phatvu1294/du-an-module-thi-nghiem-cam-bien/documents/Tai_Lieu_Ky_Thuat.pdf

TÀI LIỆU KỸ THUẬT

### 1.1. MODULE ĐẦU RA KẾT HỢP LOA ĐÈN

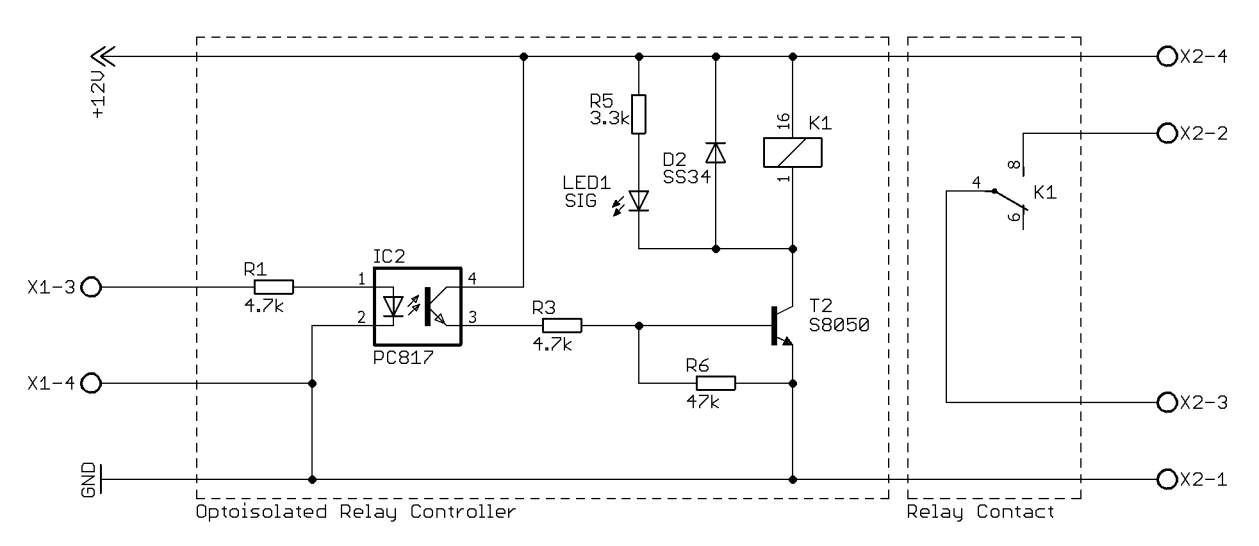
[picture p1: figure]

Hình 1. Nguyên lý module đầu ra

Khối điều khiển cuộn hút:

Để bình thường, không có dòng vào cực B của T2, T2 khoá, cuộn hút của relay K1 không có điện, tiếp điểm của relay không đổi trạng thái.

Khi X1-3 có đủ điện vào (chân 1 và 2) của opto, led phát quang hoạt động, opto dẫn, dòng điện sẽ đi từ +12V qua (chân 4 và 3) PC817, qua R3, đi vào cực B của T2, làm T2 dẫn. K1 lúc này có điện (chiều từ +12V qua K1, qua T2, về GND). K1 hoạt động, tiếp điểm của relay thay đổi trạng thái.

R1 có nhiệm vụ hạn dòng cho led phát quang opto, D2 có nhiệm vụ ngắn mạch dòng ngược sinh ra từ K1, khi K1 ngắt đột ngột (hiện tượng tự cảm trên

cuộn dây K1).

Khối tiếp điểm đầu ra:

Khối tiếp điểm đầu ra được kết nối với tải đầu ra (chẳng hạn: loa đèn).

### 1.2. MODULE CẢM BIẾN NHIỆT RTD

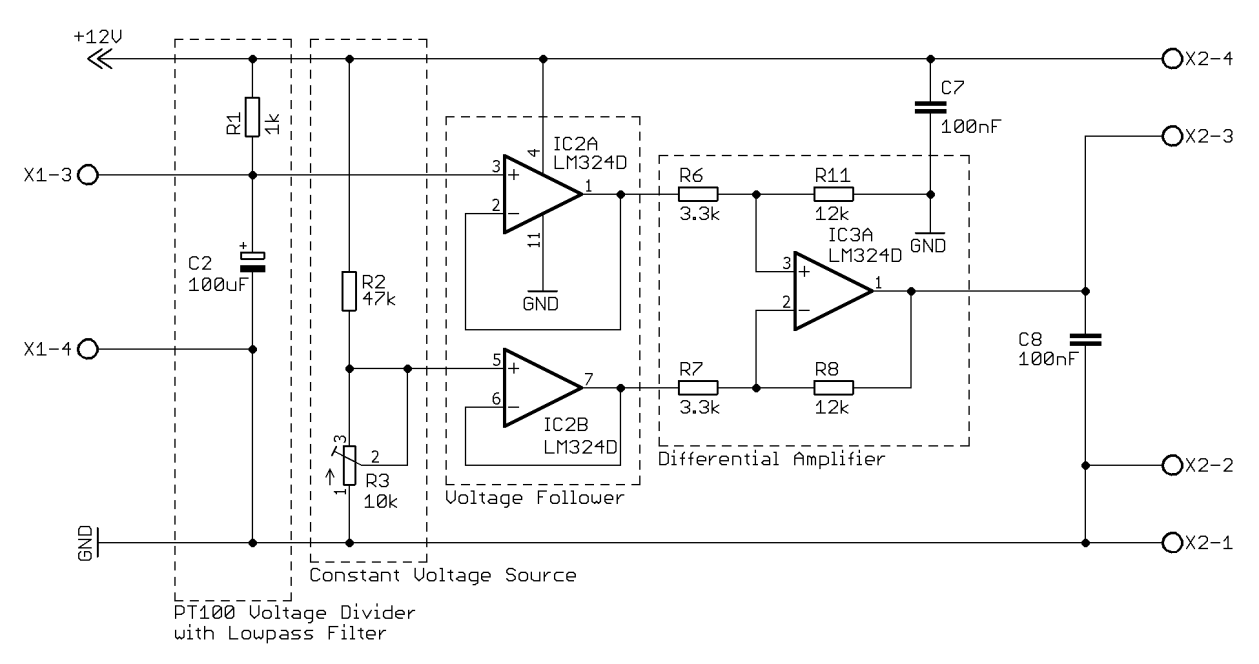
[picture p2: figure]

Hình 2. Nguyên lý module cảm biến nhiệt RTD (PT100)

Khối chia áp và lọc tần thấp RTD:

Với RTD, chúng ta sẽ chuyển tín hiệu nhiệt độ về tín hiệu điện áp, 0 đến 800°C về 0 đến 8V, như vậy 10mV sẽ ứng với 1°C.

Gắn PT100 vào X1-3 và X1-4. Lúc này RTD và R1 sẽ hình thành mạch chia áp, R1 và C2 có nhiệm vụ lọc tần thấp, đảm bảo tín hiệu ra tại điểm giữa ổn

định.

Tại nhiệt độ 0°C, tra bảng ta có giá trị điện trở là 100Ω. Điện áp tại điểm

giữa:
1.091(V)
100 1000

12 100
R | R
V | R
V
RTD0 | 1
PWR | RTD0
0 | =
+

×
=
+

×
=

Tại nhiệt độ 800°C, tra bảng ta có giá trị điện trở là là 375,7Ω. Điện áp tại

điểm giữa:
3.277(V)
375,7 1000

12 375,7
R | R
V | R
V
RTD800 | 1
PWR | RTD800
800 | =
+

×
=
+

×
=

Khối nguồn hằng số:

Khối cũng sử dụng mạch chia áp, giá trị điện áp tại điểm giữa được điều chỉnh thông qua biến trở tinh chỉnh, khối có nhiệm vụ tạo điện áp sai lệch tại điểm ban đầu trước khi đưa vào khối khuếch đại vi sai.

Khối mang áp:

Khối có nhiệm vụ chính là đệm điện áp, bảo vệ tín hiệu đầu ra, và điện áp đầu ra bằng điện áp đầu vào.

Khối khuếch đại vi sai:

Ta có điện áp tại đầu ra:

( | )
( | )

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
CONST
11 | 6 | 7
8 | 7 | 11
OUT | RTD | R

R
V | .
R | R .R
R | R .R
V | V | .

Nếu
R6 = R7

, R8 = R11

thì
( | )
( | )
( | )
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
= - ÷

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
RTD CONST
7

8
CONST
11 | 6 | 7
8 | 7 | 11
OUT | RTD | R

R
V | V | .
R

R
V | .
R | R .R
R | R .R
V | V | . | (1)
- Tại nhiệt độ 0°C ta muốn điện áp ra là 0V, thay vào (1) ta có:
( | )
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
CONST R

R
0 | 1.091 V | . | , ta có
R | 0 7 ≠ , R | 0 8 ≠ | V | 1.091(V) Þ CONST =
- Tại nhiệt đô 800°C ta muốn điện áp ra là 8V, thay vào (1) ta có:
( | ) | 3,660
2.186

8
R

R
R

R
8 3.277 1.091.

7

8

7

8 | Þ | = | = ÷

÷
ø

ö
ç

ç
è

æ
= | -
| • Chọn
R7 = 3.3k Þ R8 = 3.3k ×3,660 =12.078k ≈12k

Như vậy ta sẽ đặt giá trị nguồn hằng về 1.091(V),
R6 = R7 = 3.3k ,
R8 = R11 =12k | để chuyển đổi nhiệt độ 0 đến 800°C về 0 đến 8V (10mV/1°C).

### 1.3. MODULE CẢM BIẾN NHIỆT TCK

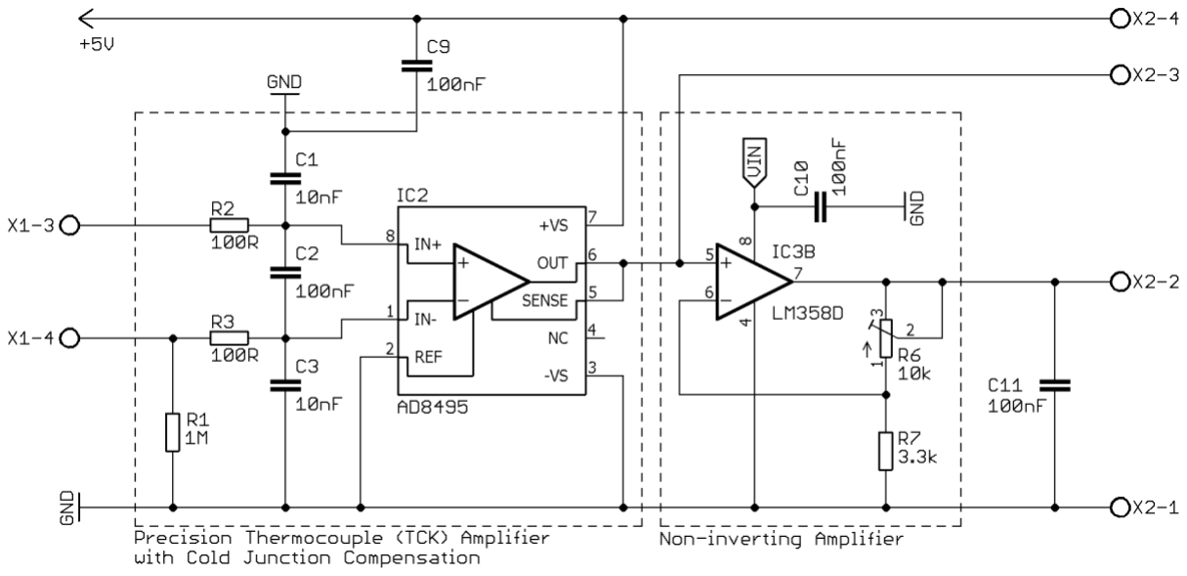
[picture p3: figure]

Hình 3. Nguyên lý module cảm biến Thermo-Couple K (TCK)

Khối chuyển đổi nhiệt TCK sang Analog AD8495:

AD8495 là IC chuyển tổi tín hiệu nhiệt độ từ cặp nhiệt can K sang điện áp, với độ phân giải 5mV/1°C. Với giải đầu vào cặp nhiệt can K từ 0 đến 1000°C sẽ cho ra điện áp 0 đến 5V.

R2, R3, C1, C2, C3 là bộ lọc tần thấp trước khi tín hiệu điện áp từ cảm biến TCK được đưa vào bộ khuếch đại.

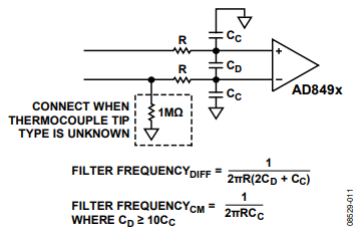
[picture p4: figure]

Điện trở kéo R1 nối đất đảm bảo đầu vào IN- của cảm biến mức 0V. Tránh gây ra thêm sai số đầu ra khi không có tín hiệu từ cảm biến.

Bộ khuếch đại tín hiệu không đảo:

Tín hiệu ra từ bộ chuyển đổi sẽ được đưa vào bộ khuếch đại không đảo, bộ này sẽ khuếch đại tín hiệu điện áp lên 2 lần để điện áp đầu ra đạt được từ 0 đến

10V (10mV/1°C).

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
= | +

7

6

OUT | OUT _ AD8495 | R R
V | V | . 1

Để tín hiệu được khuếch đại lên 2 lần ta có: 2
R

R
1

7

6 + =
, chọn

R7 = 3.3k Þ R6 = 3.3k

, như vậy ta sẽ điều chỉnh biến trở R6

về 3.3k.

### 1.4. MODULE CẢM BIẾN NHIỆT BÁN DẪN

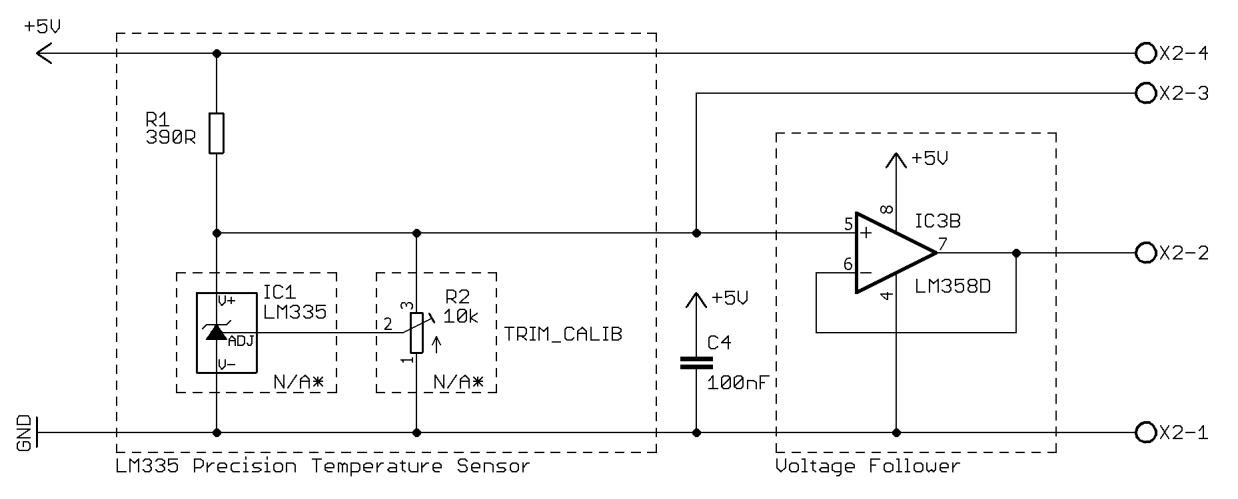
[picture p5: figure]

Hình 4. Nguyên lý module cảm biến nhiệt bán dẫn LM335

Khối cảm biến nhiệt LM335:

LM335 là cảm biến nhiệt độ với đầu ra tỉ lệ với điện áp 10mV/1°K. Giải nhiệt độ đo được từ -55°C đến 150°C.

R1 được chọn để đảm bảo tín hiệu dòng điện cung cấp vào LM335 nằm trong dải từ 400µA đến 5mA.

Hiệu chỉnh nhiệt độ sử dụng chân ADJ:

Một biến trở R2 được kết nối với LM335 được kết nối với LM335 cho phép hiệu chỉnh đầu ra khi biết chính xác một giá trị nhiệt độ cho trước.

0

OUT _ T | OUT _ T
T

T
V | V
| 0
= | ×

Với T là nhiệt độ sau khi hiệu chỉnh (°K), T0

là nhiệt độ hiệu chỉnh (°K).

Khối mang áp:

Khối có nhiệm vụ chính là đệm điện áp, bảo vệ tín hiệu đầu ra, và điện áp đầu ra bằng điện áp đầu vào. Tín hiệu điện áp Analog được đo tại đầu ra khối LM335 (X2-3) hoặc đầu ra của đầu ra của khối mang áp (X2-2).

### 1.5. MODULE CẢM BIẾN ÁNH SÁNG LDR

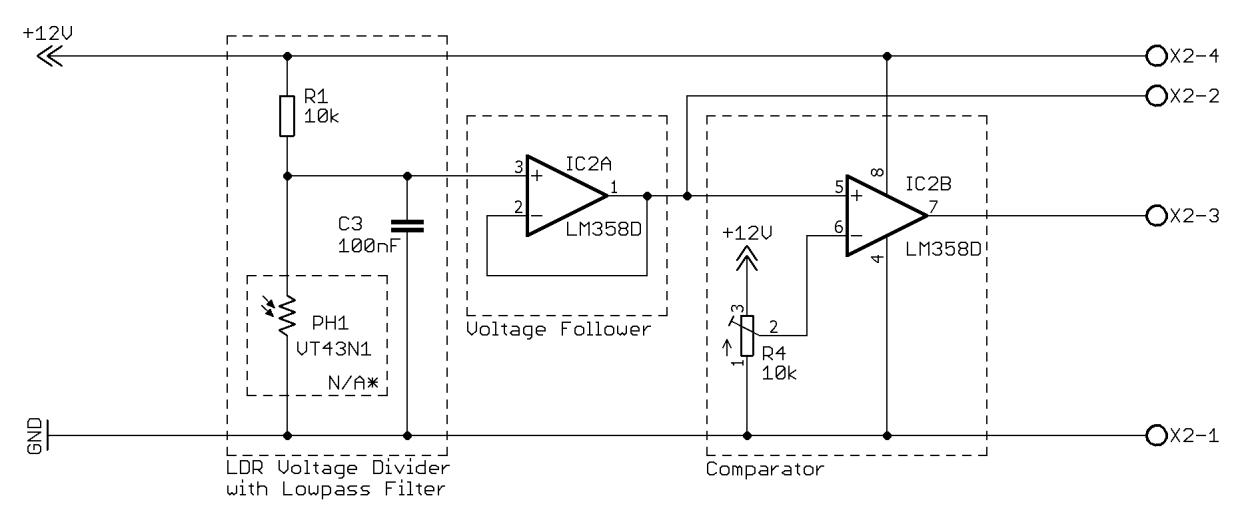
[picture p6: figure]

Hình 5. Nguyên lý module cảm biến ánh sáng LDR

Khối chia áp và lọc LDR:

R1 và PH1 hình thành mạch chia áp, ta có điện áp ra tại điểm giữa:

R | ?
R | R

R1
V | 12 V | 12 12 | PH1
1 | PH1
PH1 | R1 | Þ | =
+
= | - | = | - | ×

Lưu ý: 12V là nguồn lý tưởng, cần đo lại điện áp nguồn cung cấp để tính

chính xác hơn.

Khối mang áp:

Khối có nhiệm vụ chính là đệm điện áp, bảo vệ tín hiệu đầu ra, và điện áp đầu ra bằng điện áp đầu vào. Tín hiệu điện áp Analog được đo tại điểm giữa hoặc đầu ra của đầu ra của khối mang áp.

Khối so sánh:

Với khối so sánh ta có:

î

í

ì
=

+

S

S
OUT V

V
V
+ | -
+ | -
<

>

IN | IN
IN | IN
V | V
V | V
với
VS

là nguồn cấp cho OPAM.

Trong mạch
VS+ | =12V

(nối với nguồn cung cấp) và VS- = 0V

(nối với

GND).

Một biến trở
R4 | có nhiệm vụ đặt điện áp tại
VIN-

(điện áp so sánh). Và
trong mạch được điều chỉnh cứng bằng nửa điện áp nguồn cung cấp (khoảng

6V).

Như vậy khi được chiếu sáng, điện trở PH1 rất thấp, tín hiệu điện áp
VPH1

giảm mạnh, khi đó
VPH1 < VIN-

, lúc này điện áp ra
VOUT = 0V . Ngược lại, khi trong bóng tối, điện trở trên tăng mạnh cỡ MΩ, điện áp
VPH1

tăng mạnh, khi đó

VPH1 > VIN- và điện áp ra
VOUT =12V

(lý thuyết, thực tế khoảng 10.3V với

OPAM LM358).

### 1.6. MODULE ĐO TỐC ĐỘ ĐỘNG CƠ ENCODER

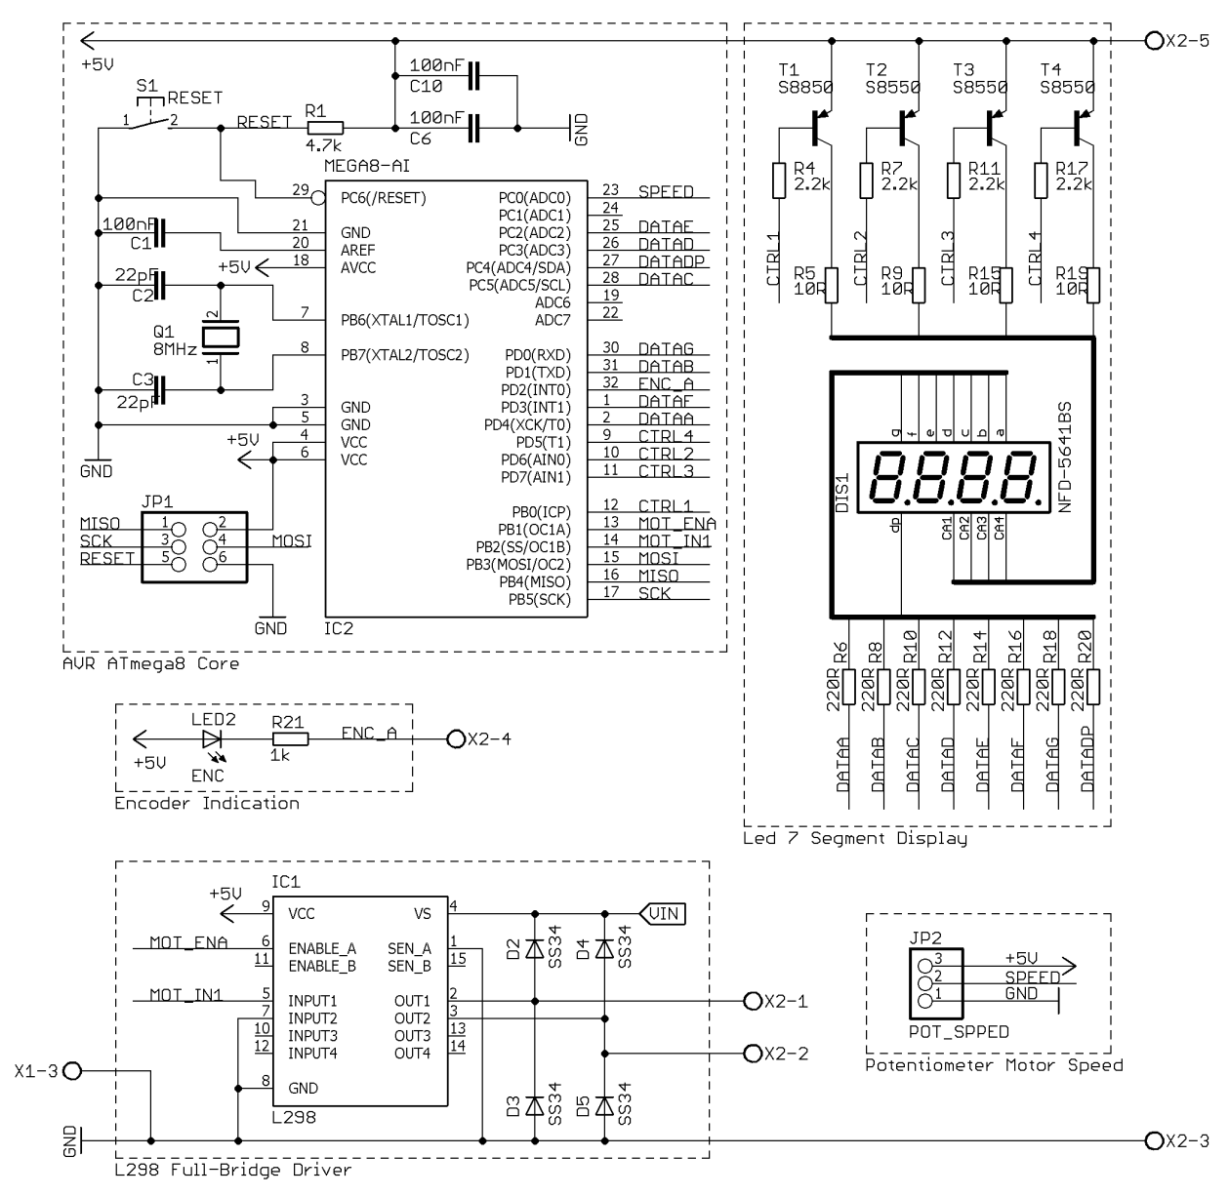
[picture p7: figure]

Hình 6. Nguyên lý bộ điều khiển module đo tốc độ encoder

Bộ điều khiển tốc độ và đo tốc sử dụng vi điều khiển ATMega8 làm bộ điều khiển chính, khối hiển thị số xung trên giây sử dụng LED7 thanh 4 số, driver điều khiển động cơ L298. Tốc độ động cơ sẽ được điều chỉnh bằng biến trở tích hợp trong bộ điều khiển.

Hướng dẫn tính toán tốc độ động cơ:

Với Động Cơ Encoder Giảm Tốc GM25-370 (50RPM) có các thông số

kỹ thuật như sau:

- Điện áp hoạt động: 12VDC
- Dòng không tải: 100mA
- Xung: 26 Xung/Vòng
- Tỉ số truyền: 1/78
- Công suất: 3W
- Kích thước: 50x24mm
- Đường kính trục: Φ4
- Chiều dài dây: 142mm
- Trọng lượng: 110g

Giả sử bộ điều khiển hiển thị 1608 xung/giây. Ta có tốc độ quay của động cơ khi chưa qua hộp giảm tốc là:

61,84(vòng / giây)
26

1608 N(rps) = =
hay:

N(rpm) = 61,84×60 = 3710,4(vòng / phút)

Tốc độ quay của động cơ khi qua hộp số là:

47,57(vòng / phút)
78

3710,4
NGEAR = | =

Lưu ý, với mỗi giá trị điện áp đặt vào 2 đầu động cơ, chúng ta sẽ có các tốc độ khác nhau ứng với mỗi mức điện áp đó.

### 1.7. MODULE CẢM BIẾN TỪ TRƯỜNG HALL

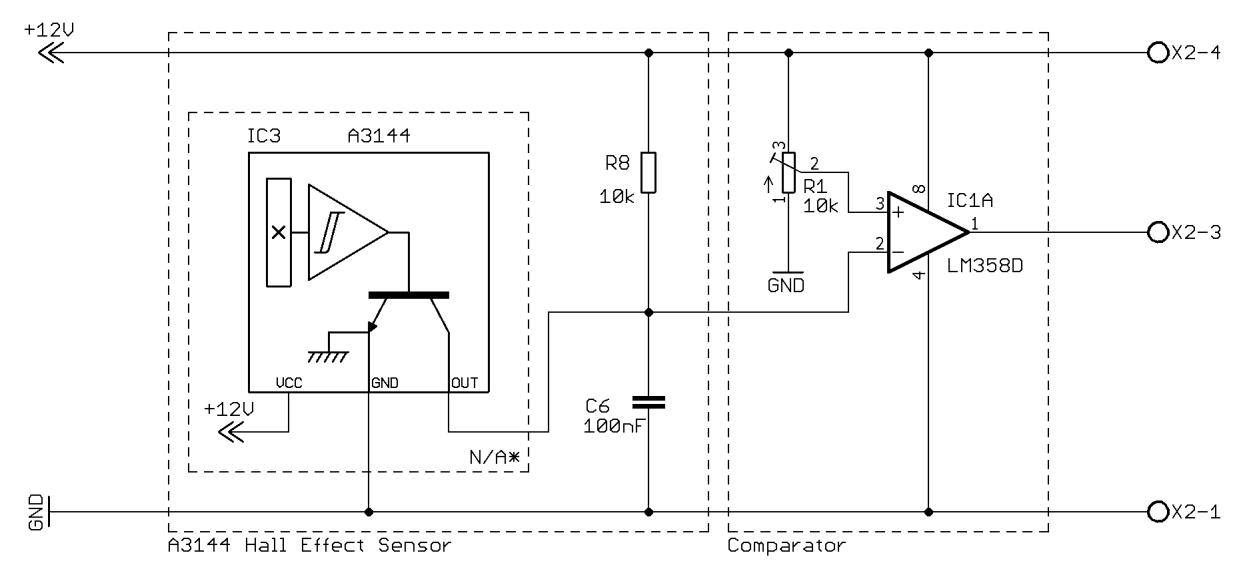
[picture p8: figure]

Hình 7. Nguyên lý module cảm biến từ trường Hall

Khối cảm biến từ trường A3144:

A3144 là một cảm biến từ khi có từ trường (nam châm) đặt vào đầu cảm biến thì sẽ có sự thay đổi trạng thái ở chân OUT.

Một điện trở
R8

được sử dụng để phân cực cho transistor được tích hợp

bên trong, đồng thời đặt mức điện áp ban đầu tại chân OUT mức cao. Khi có từ trường đặt vào đầu vào cảm biến, cực B transistor NPN tích hợp có tín hiệu, transitor lúc này khóa lại, làm cho chân OUT được chuyển xuống mức thấp.

Khối so sánh:

Một bộ so sánh đầu ra cho phép đảo mức tín hiệu logic tại đầu ra của khối.

### 1.8. MODULE CẢM BIẾN HỒNG NGOẠI

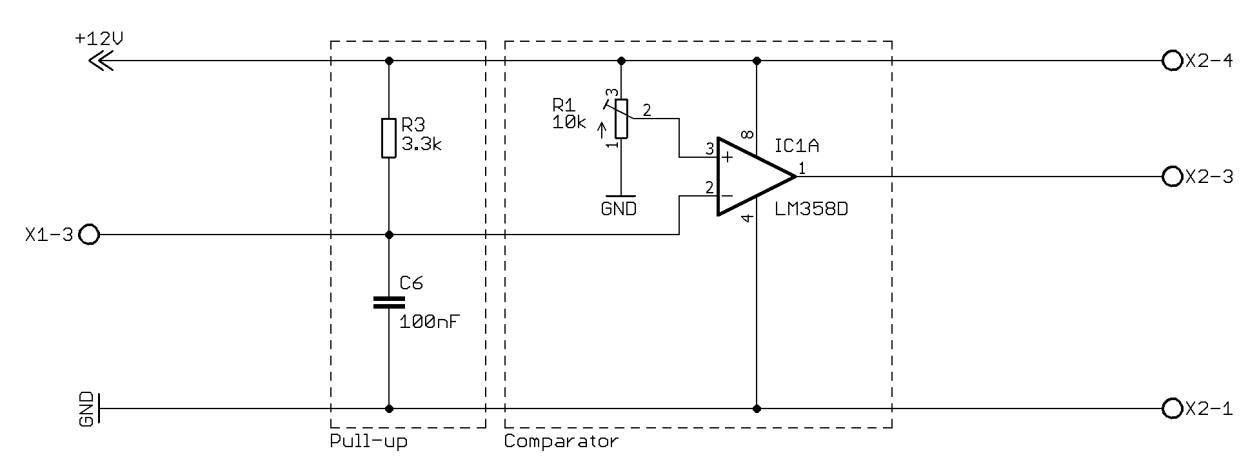
[picture p9: figure]

Hình 8. Nguyên lý module cảm biến hồng ngoại

phản xạ và thu phát độc lập

Khối trở kéo:

Cảm Biến Hồng Ngoại Phản Xạ E3F-DS30C4 là loại cảm biến NPN, bình thường khi chưa có vật cản, bộ thu RX không thể thu được tín hiệu phát ra từ TX, đầu ra tín hiệu đầu ra ở mức cao. Khi có vật cản, tia hồng ngoại phát ra từ TX sẽ được phản xạ lại bộ thu RX làm cho tín hiệu đầu ra đảo trạng thái xuống mức thấp.

Tương tự với Cảm Biến Hồng Ngoại Thu Phát Độc Lập E3Z-T61. Bộ phát và bộ thu sẽ được đặt đối mặt nhau, bình thường khi chưa có vật cản, bộ thu RX luôn nhận được tín hiệu từ TX, đầu ra tín hiệu đầu ra ở mức cao. Khi có vật cản, tia hồng ngoại bị cản lại và không thể đưa tới bộ thu làm cho tín hiệu đầu ra bị đảo trạng thái xuống mức thấp.

Khối so sánh:

Một bộ so sánh đầu ra cho phép đảo mức tín hiệu logic tại đầu ra của khối.

### 1.9. MODULE CẢM BIẾN TIỆM CẬN

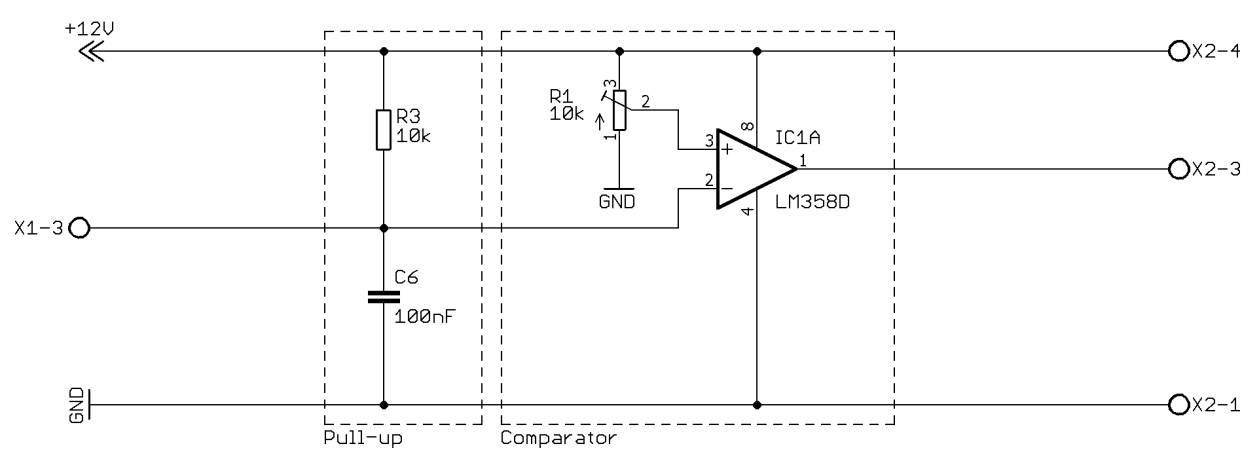
[picture p10: figure]

Hình 9.1. Nguyên lý module cảm biến tiệm cận kim loại

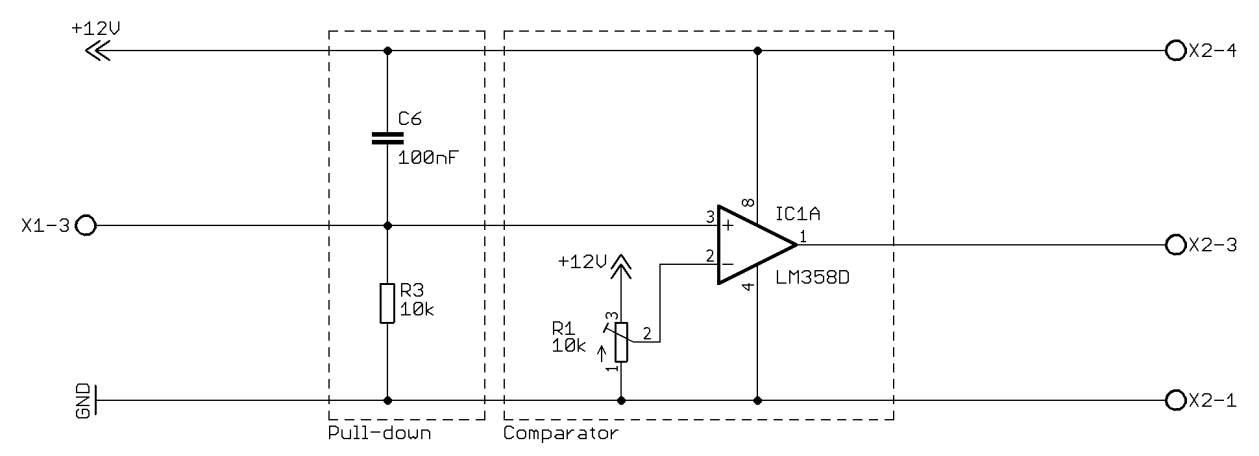
[picture p11: figure]

Hình 9.2. Nguyên lý module cảm biến tiệm cận kim loại và phi kim

Khối trở kéo:

Cảm Biến Tiệm Cận Omron E2E-X10ME1 là loại cảm biến NPN tiệm cận kim loại, bình thường khi chưa có vật cản kim loại, đầu ra tín hiệu đầu ra ở mức cao. Khi có vật cản kim loại, tín hiệu đầu ra đảo trạng thái xuống mức thấp.

Tương tự với Cảm Biến Tiệm Cận Omron E2K-X4MF1 là loại cảm biến

PNP tiệm cận kim loại và phi kim, bình thường khi chưa có vật cản kim loại hoặc phi kim, đầu ra tín hiệu đầu ra ở mức thấp. Khi có vật cản kim loại hoặc phi kim tín hiệu đầu ra bị đảo trạng thái lên mức cao.

Khối so sánh:

Một bộ so sánh đầu ra cho phép đảo mức tín hiệu logic tại đầu ra của khối

(kim loại) hoặc giữ nguyên trạng thái (kim loại và phi kim).

### 1.10. MODULE KHỐI NGUỒN

### 1.10.1. Module chuyển đổi điện áp trên các module

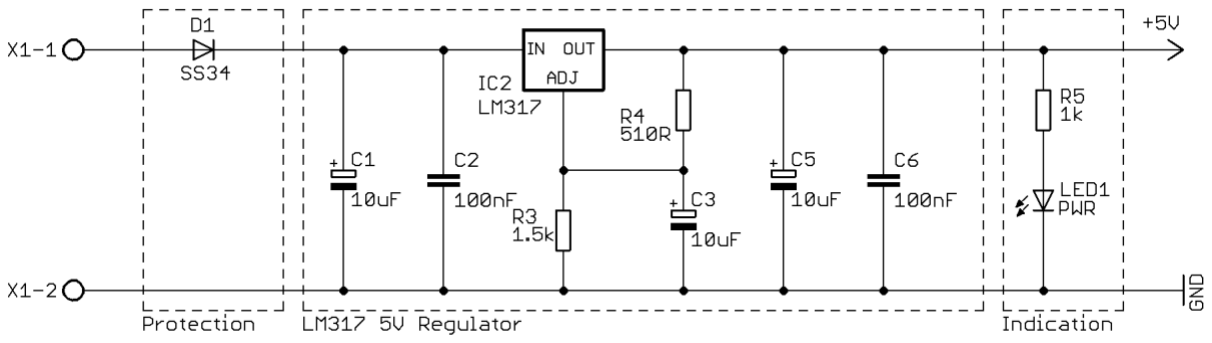
[picture p12: figure]

Hình 10.1. Nguyên lý bộ ổn áp +5V trên các module

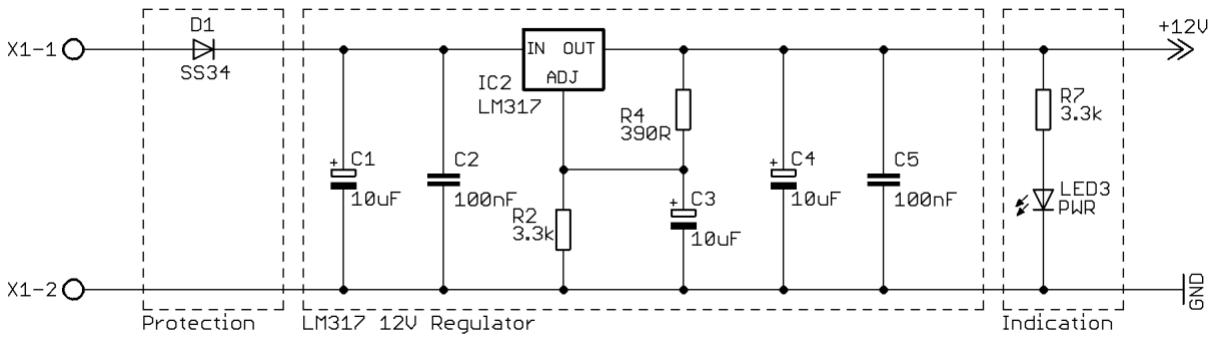
[picture p13: figure]

Hình 10.2. Nguyên lý bộ ổn áp +12V trên các module

Trên các bộ ổn áp của các module đều được tích hợp thêm diode bảo vệ, chống ngược khi cấp nhầm, khối ổn áp được thiết kế sử dụng dựa trên IC nguồn LM317 (LM337 ổn áp -), đây là dòng IC chuyển đổi hiệu suất cao thay thế cho dòng LM78XX. Tuy nhiên do sự sai số trên các trở chỉnh ADJ
R4

và
R2

dẫn

đến điện áp ra trên các module có sai số nhất định, do đó khi tính toán chúng ta cần đo lại điện áp nguồn cung cấp để hạn chế sai số.

### 1.10.2. Module nguồn

Đây là khối nguồn tạo các mức áp ra +15V, -15V, 5V để cung cấp cho các module hoạt động. Dòng cung cấp tối đa lên tới 5A.

GIAO DIỆN MODULE

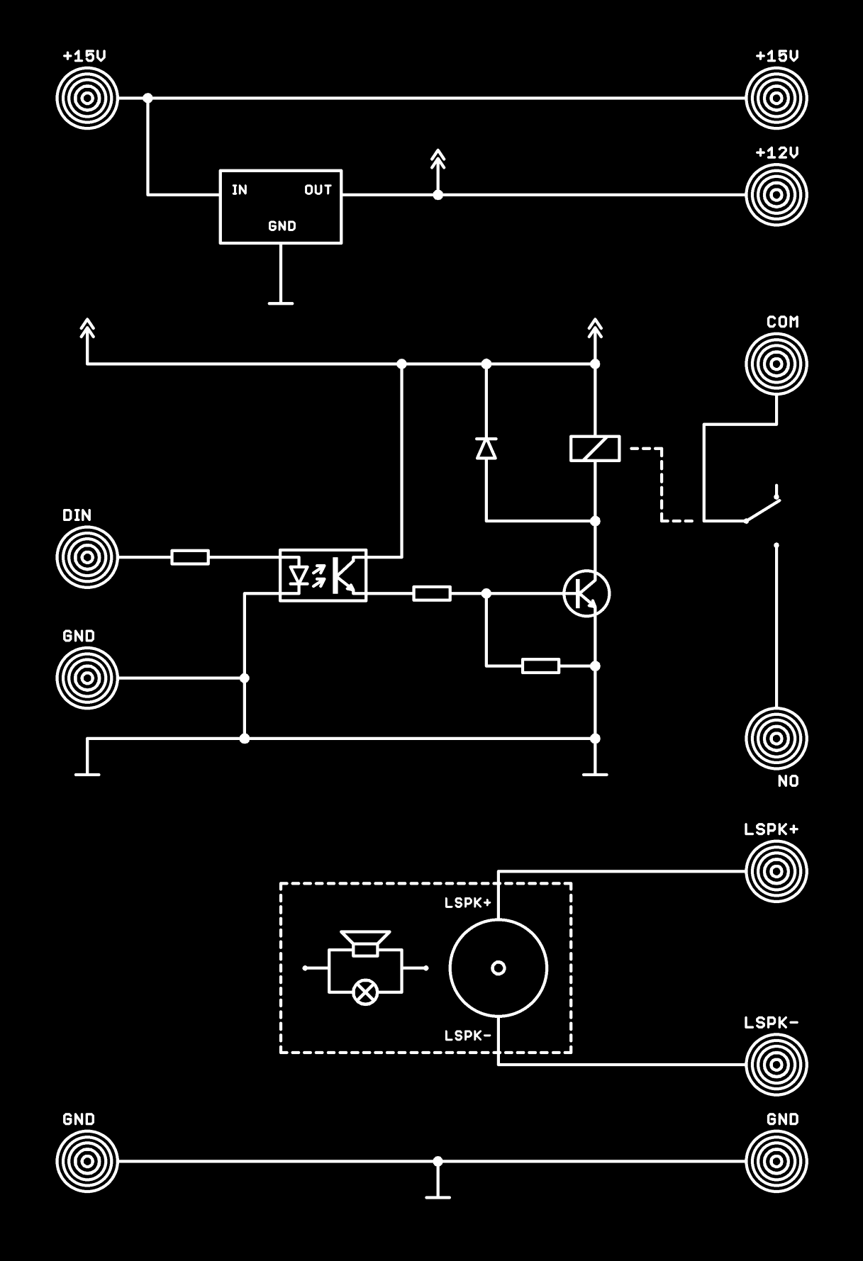
[picture p14: figure]

Hình 11. Giao diện module đầu ra

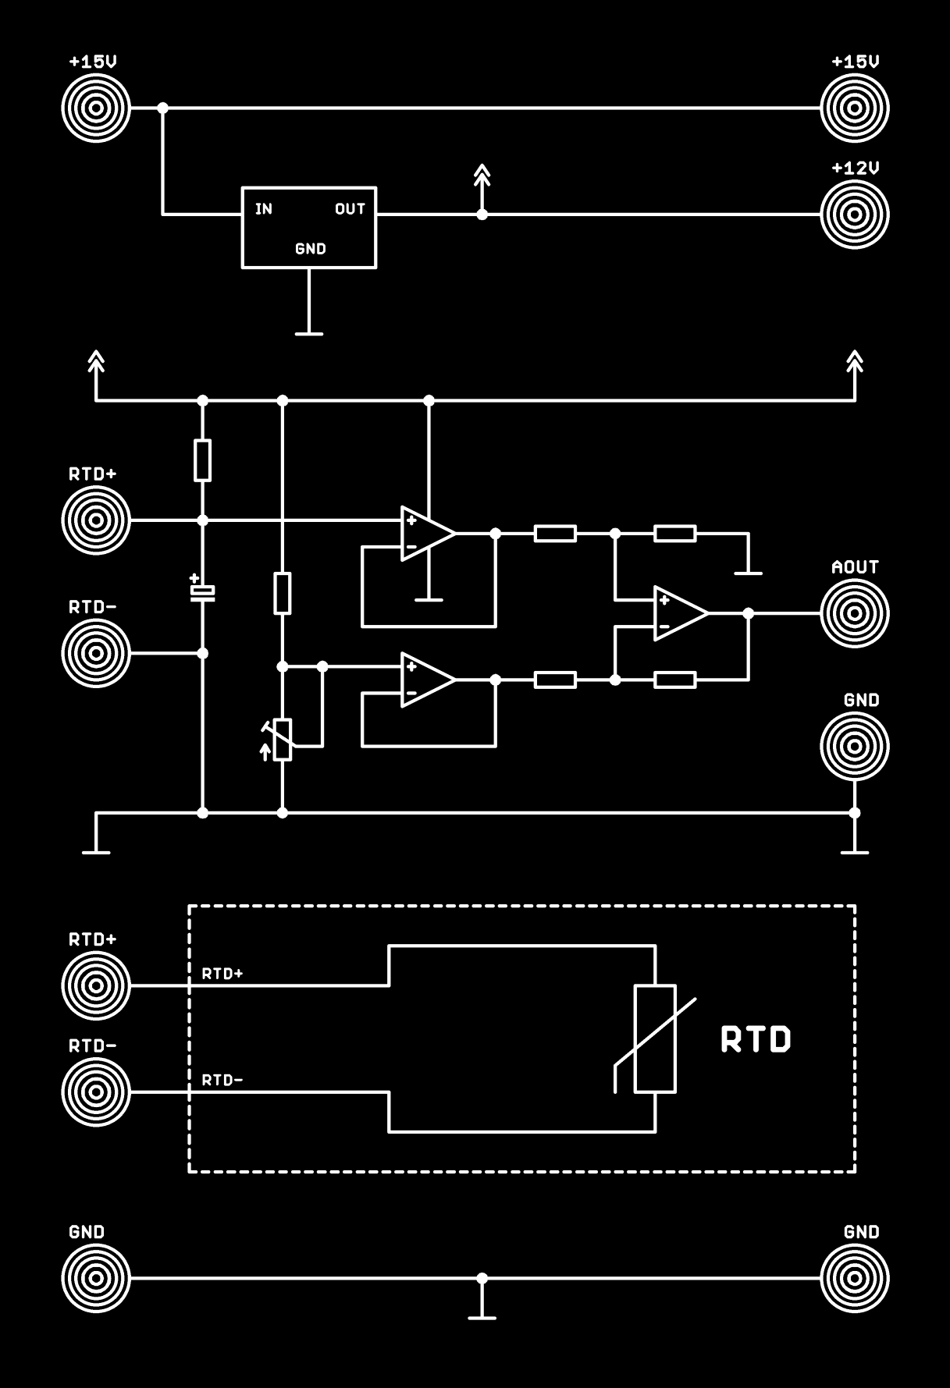
[picture p15: figure]

Hình 12. Giao diện module cảm biến nhiệt RTD (PT100)

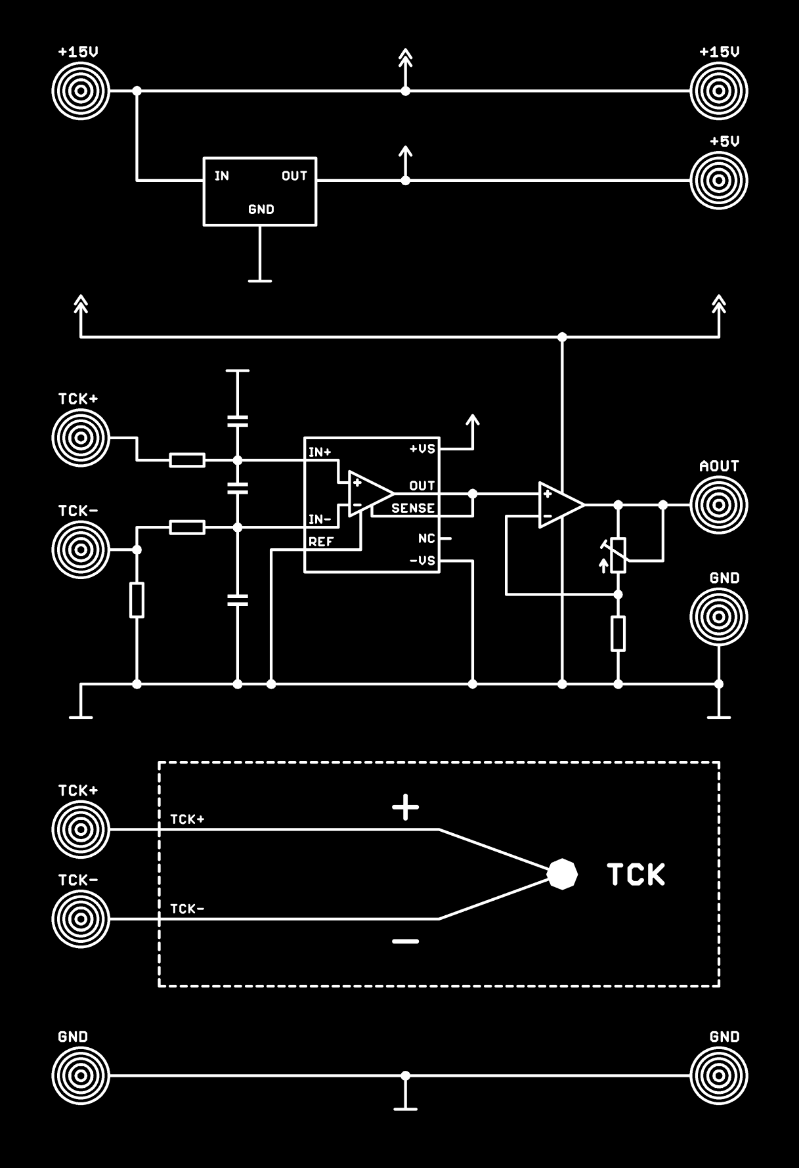
[picture p16: figure]

Hình 13. Giao diện module cảm biến nhiệt TCK

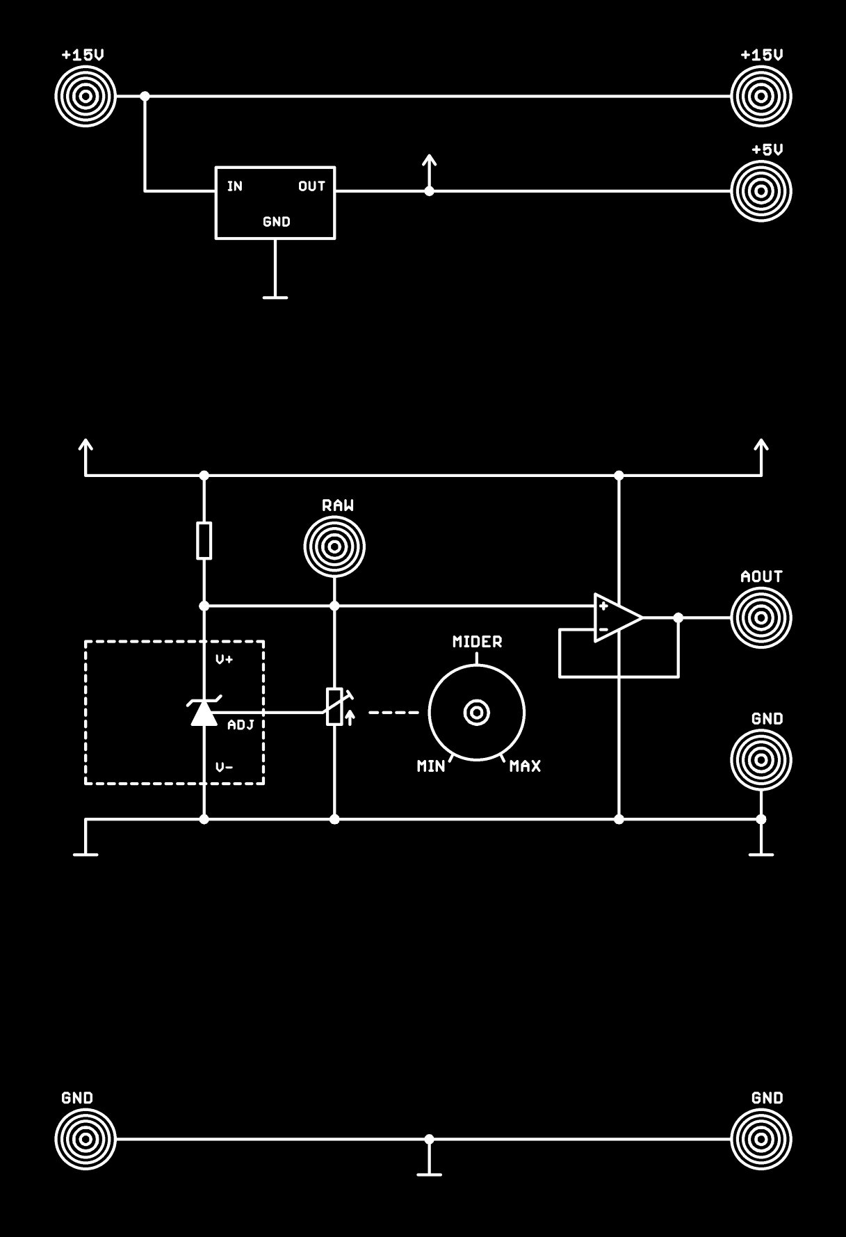
[picture p17: figure]

Hình 14. Giao diện module cảm biến nhiệt bán dẫn LM335

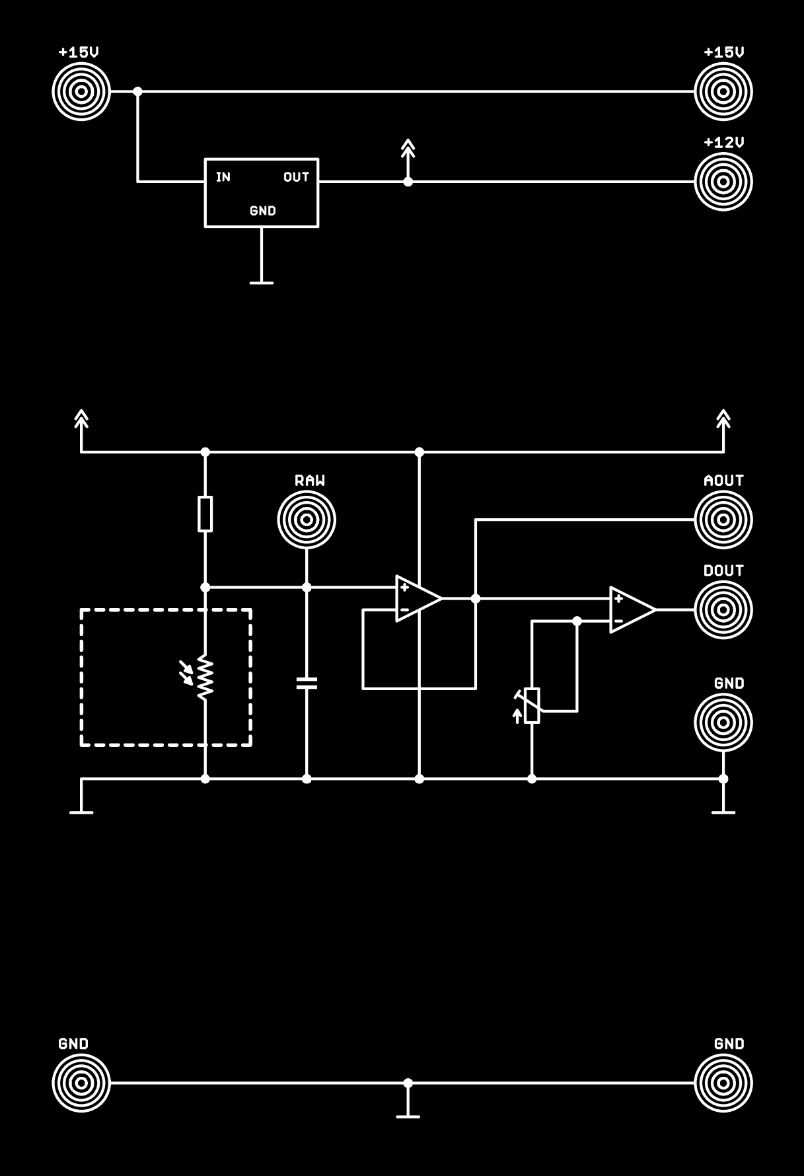
[picture p18: figure]

Hình 15. Giao diện module cảm biến ánh sáng LDR

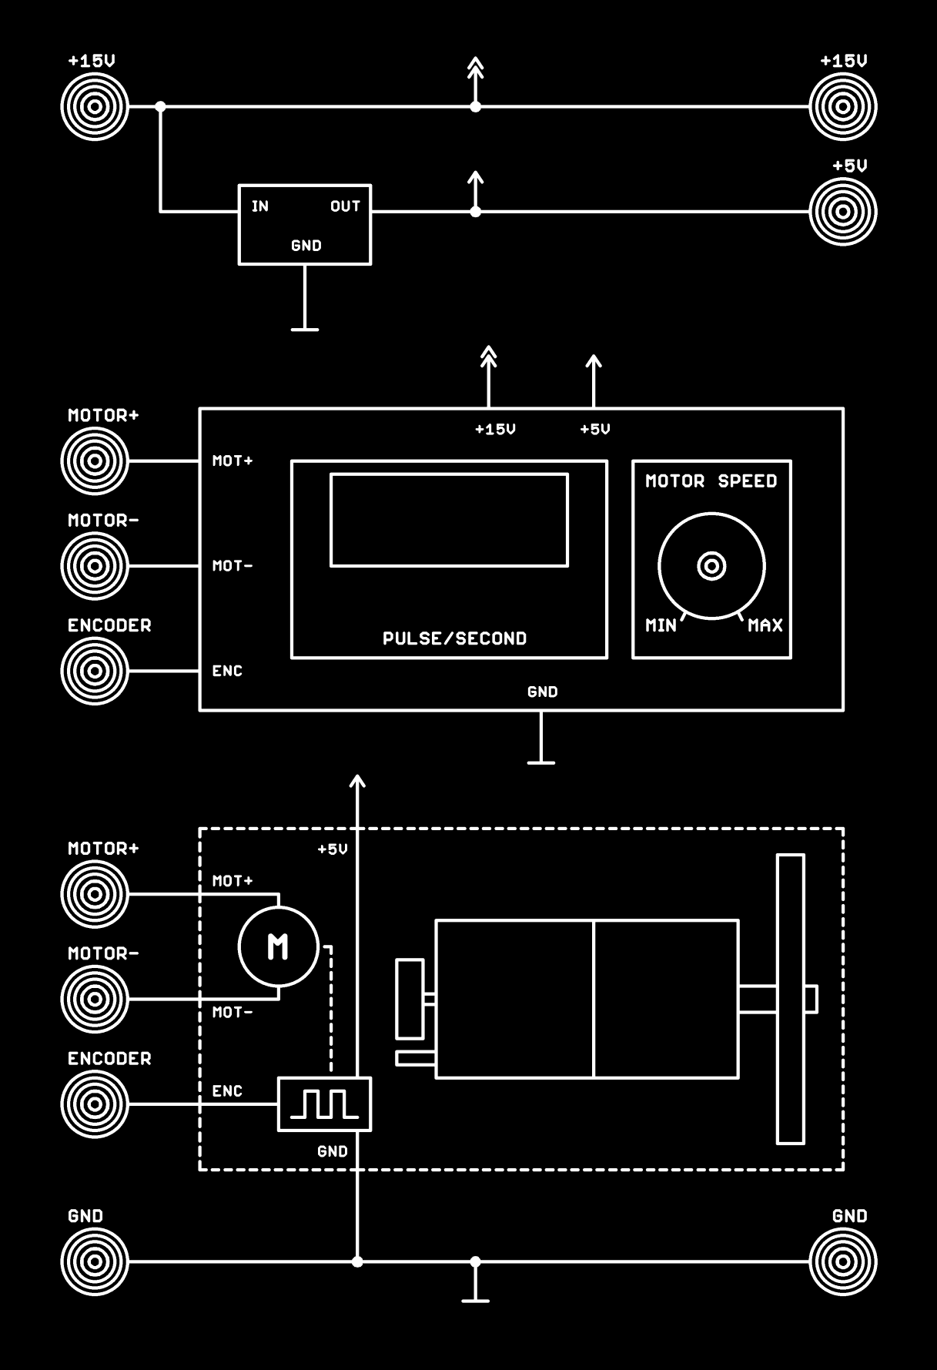
[picture p19: figure]

Hình 16. Giao diện module cảm biến đo tốc độ động cơ encoder

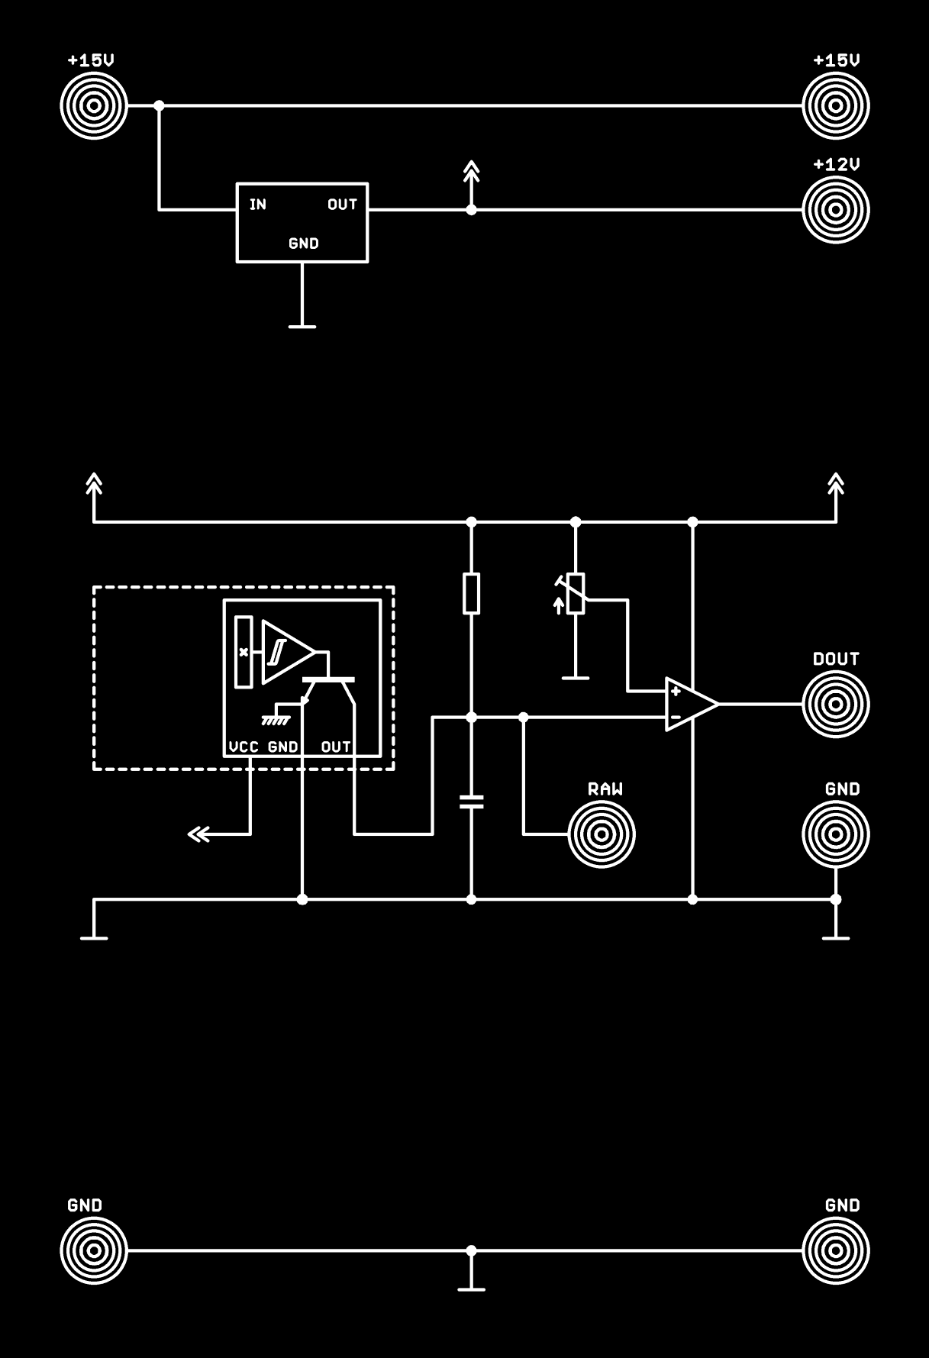
[picture p20: figure]

Hình 17. Giao diện module cảm biến từ trường Hall

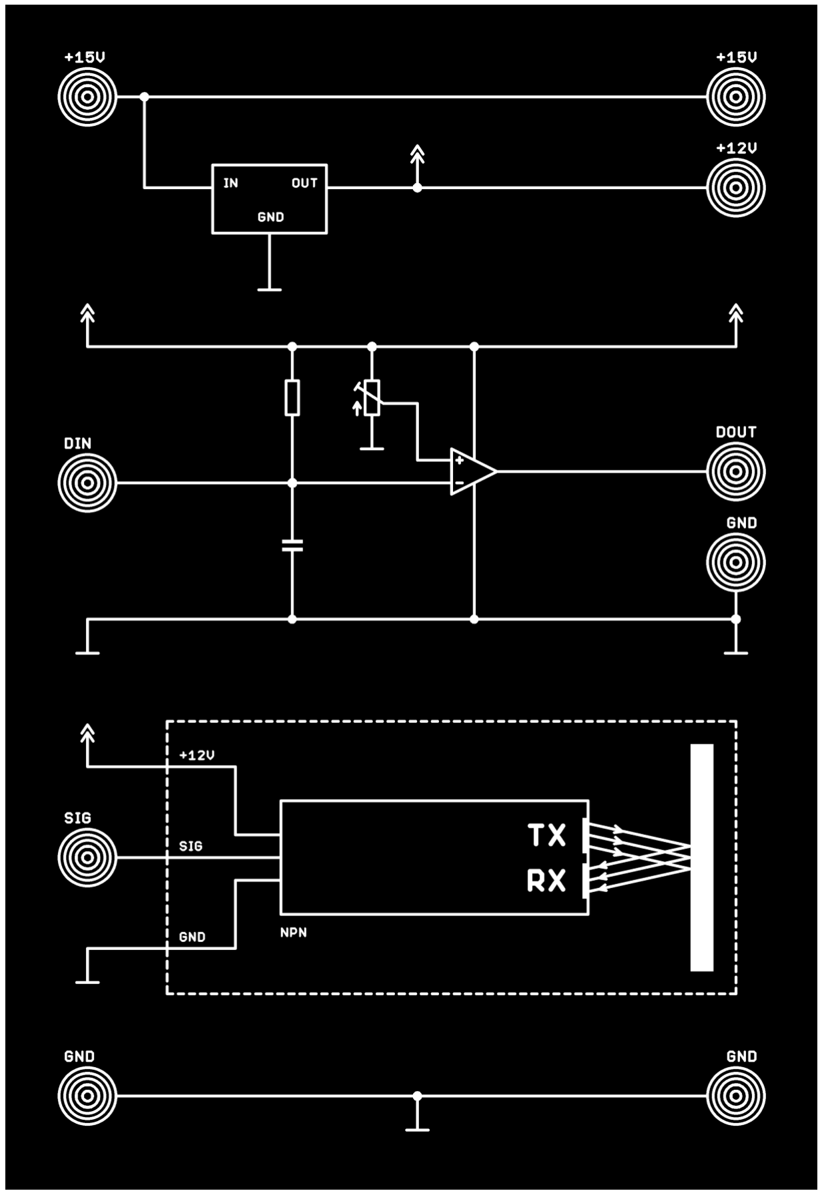
[picture p21: figure]

Hình 18. Giao diện module cảm biến hồng ngoại phản xạ

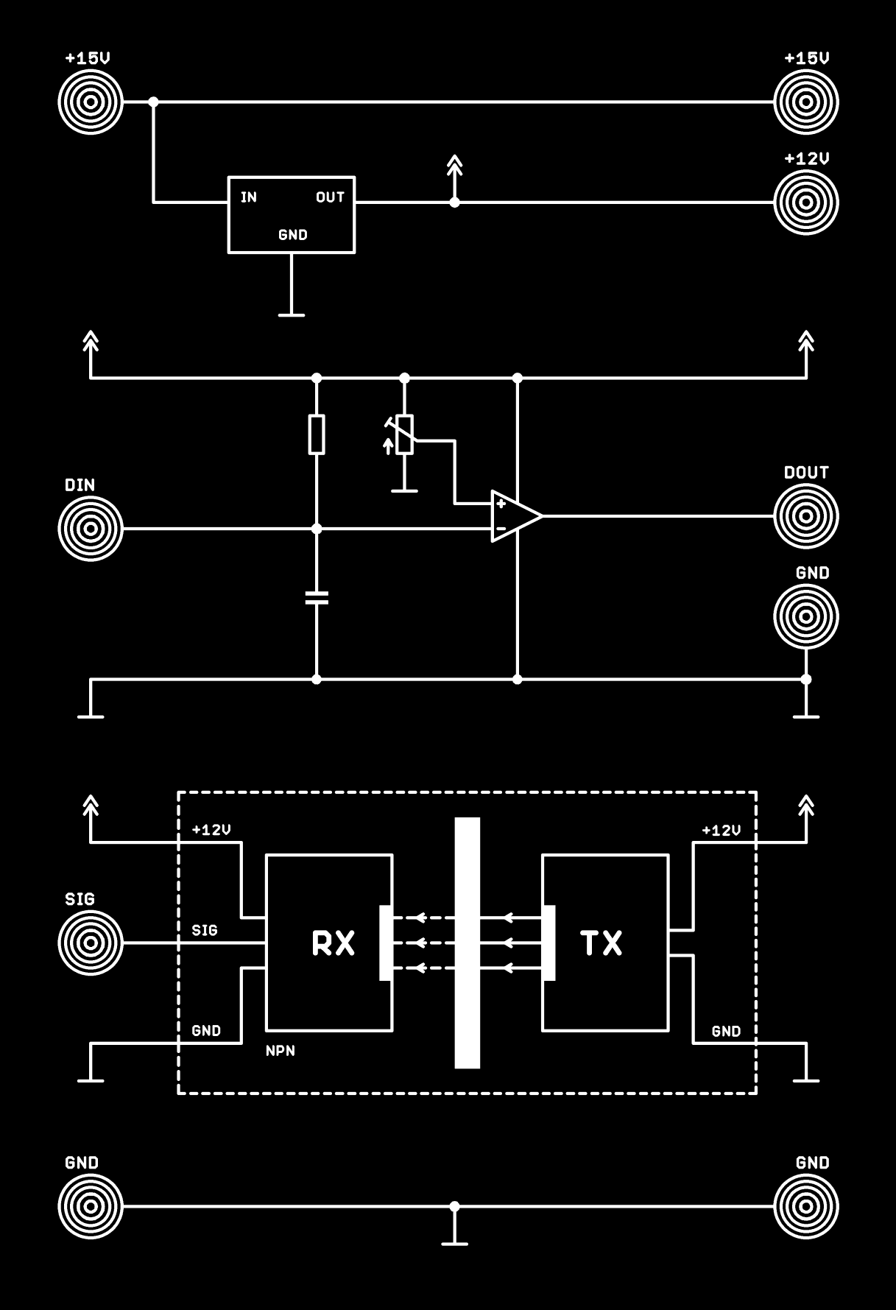
[picture p22: figure]

Hình 19. Giao diện module cảm biến hồng ngoại thu phát độc lập

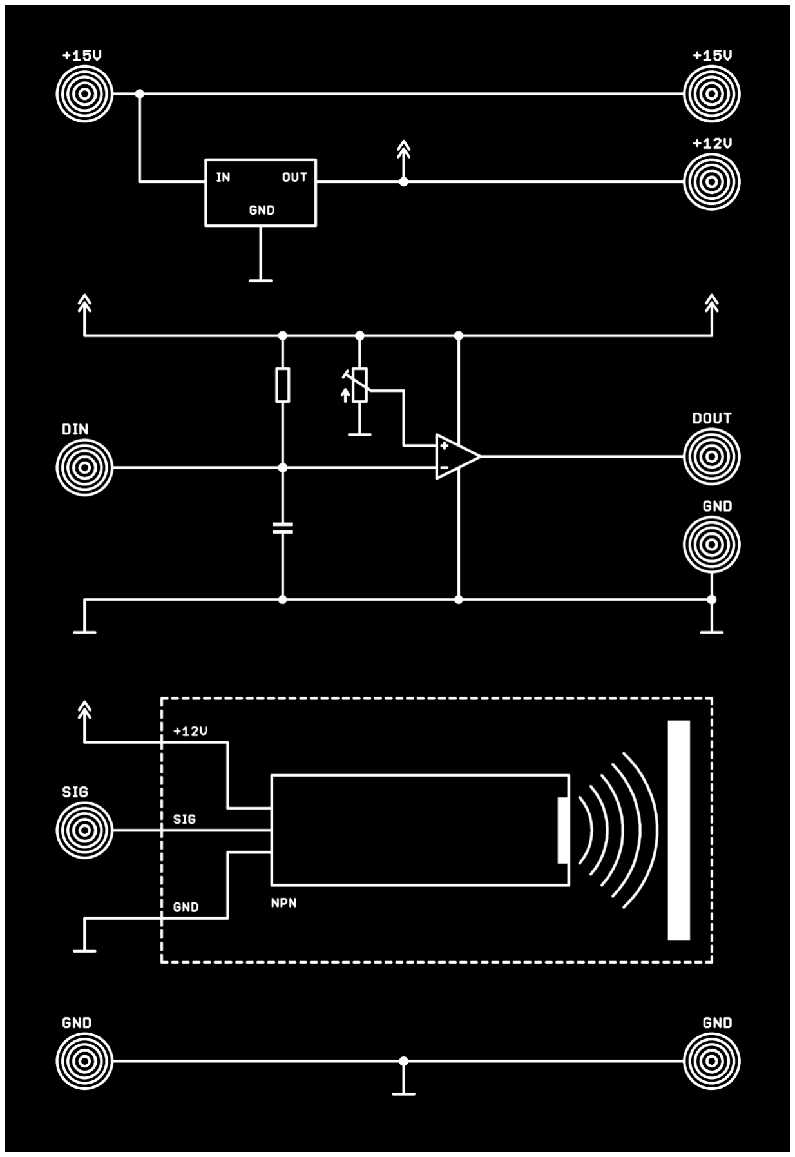
[picture p23: figure]

Hình 20. Giao diện module cảm biến tiệm cận kim loại

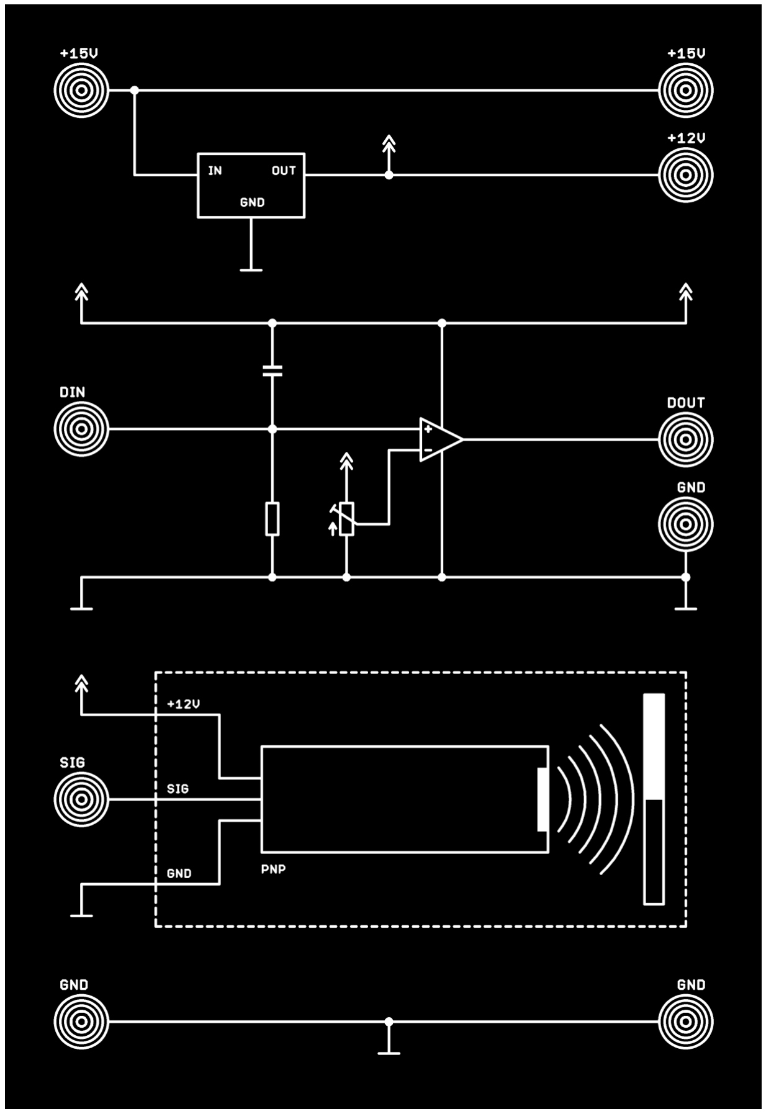
[picture p24: figure]

Hình 21. Giao diện module cảm biến tiệm cận kim loại và phi kim

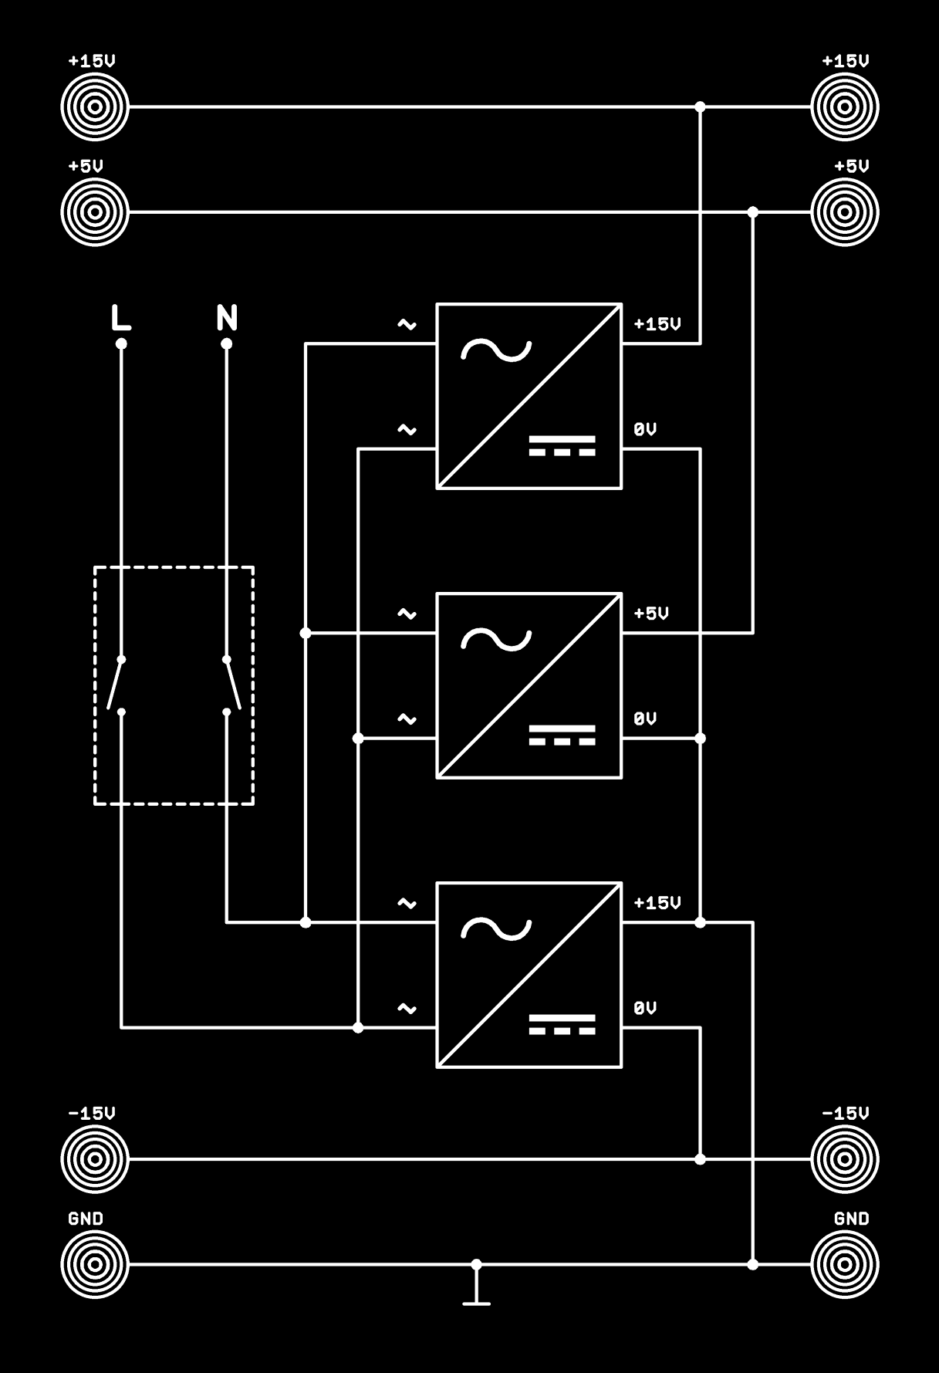
[picture p25: figure]

Hình 22. Giao diện module nguồn

TÀI LIỆU THAM KHẢO

[1] Precision Thermocouple Amplifiers with Cold Junction Compensation (https://www.analog.com/media/en/technical-documentation/data-sheets/ad8494_8495_8496_8497.pdf)
[2] LMx35, LMx35A Precision Temperature Sensors (https://www.ti.com/lit/ds/snis160e/snis160e.pdf?ts=1604144923613)
[3] LM317 3-Terminal Adjustable Regulator (https://www.ti.com/lit/ds/symlink/lm317.pdf?ts=1604200873054)
[4] Sensitive Hall Effect Switches for High-Temperature Operation (https://www.elecrow.com/download/A3141-2-3-4-Datasheet.pdf)
[5] Ứng dụng mạch khuếch đại thuật toán (https://vi.wikipedia.org/wiki/%E1%BB%A8ng_d%E1%BB%A5ng_m%E1%BA%A1ch_khu%E1%BA%BFch_%C4%91%E1%BA%A1i_thu%E1%BA%ADt_to%C3%A1n)
