phatvu1294/du-an-module-thi-nghiem-cam-bien/interface/Module Cam Bien Hong Ngoai Phan Xa.png

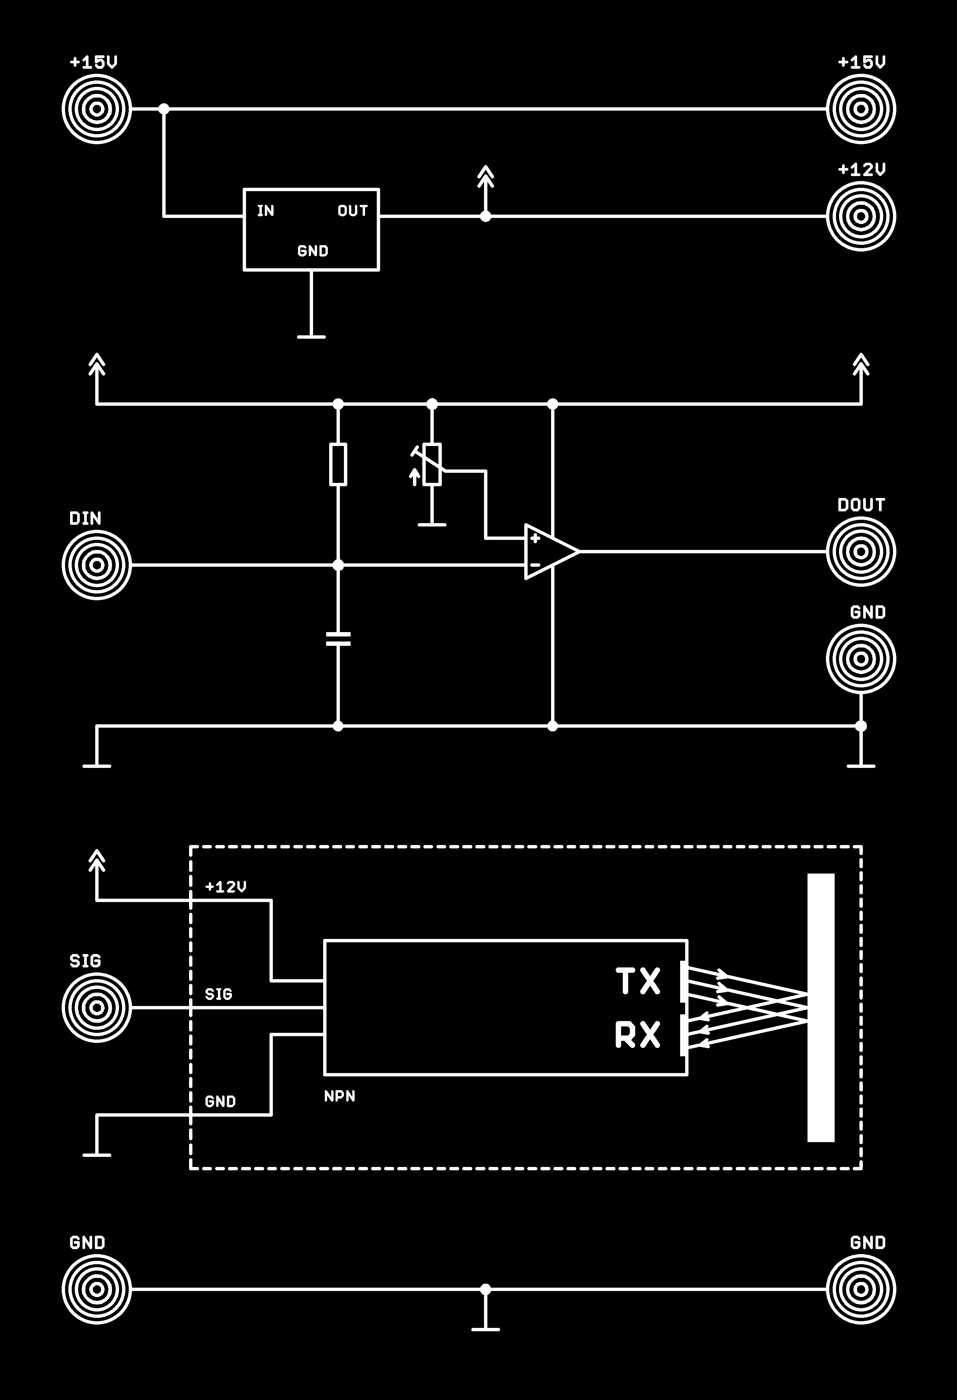
interface/Module Cam Bien Hong Ngoai Phan Xa.png
