phatvu1294/du-an-module-thi-nghiem-cam-bien/interface/Module Cam Bien Tiem Can Dien Dung.png

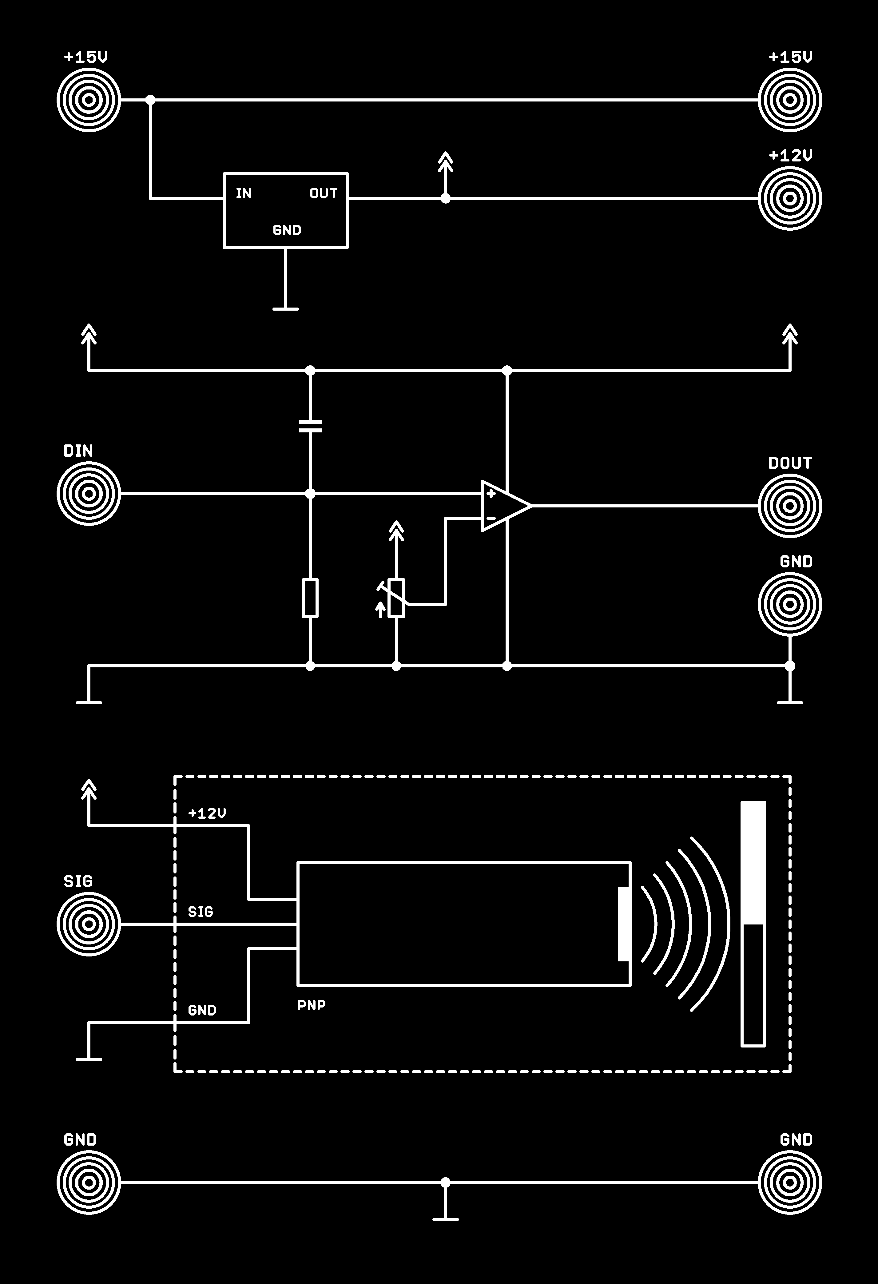
interface/Module Cam Bien Tiem Can Dien Dung.png
