phatvu1294/du-an-module-thi-nghiem-cam-bien/(list of files, drawings)

Other design files:
simulate/00. RegulatorDesignLM317.pdsprj
simulate/01. ModuleDauRa.pdsprj
simulate/02. ModuleCamBienLM335.pdsprj
simulate/03. ModuleCamBienTCK.pdsprj
simulate/04. ModuleCamBienPT100.pdsprj
simulate/05. ModuleCamBienLDR.pdsprj
simulate/06. ModuleCamBienHongNgoai.pdsprj
simulate/07. ModuleCamBienHall.pdsprj
simulate/08. ModuleCamBienTiemCan.pdsprj
simulate/09. ModuleDoTocDoEncoder.pdsprj
